londonhackspace/acnode-serialreader/Hardware/Readme.md

ACNode Serial Reader Hardware
=============

Errata - V1.1
----
* The RX and TX lines are backwards on connector J6 - Silkscreen is as intended NOT as implemented!
