londonhackspace/acnode-serialreader/Hardware/ACNodeReader-schematic.pdf

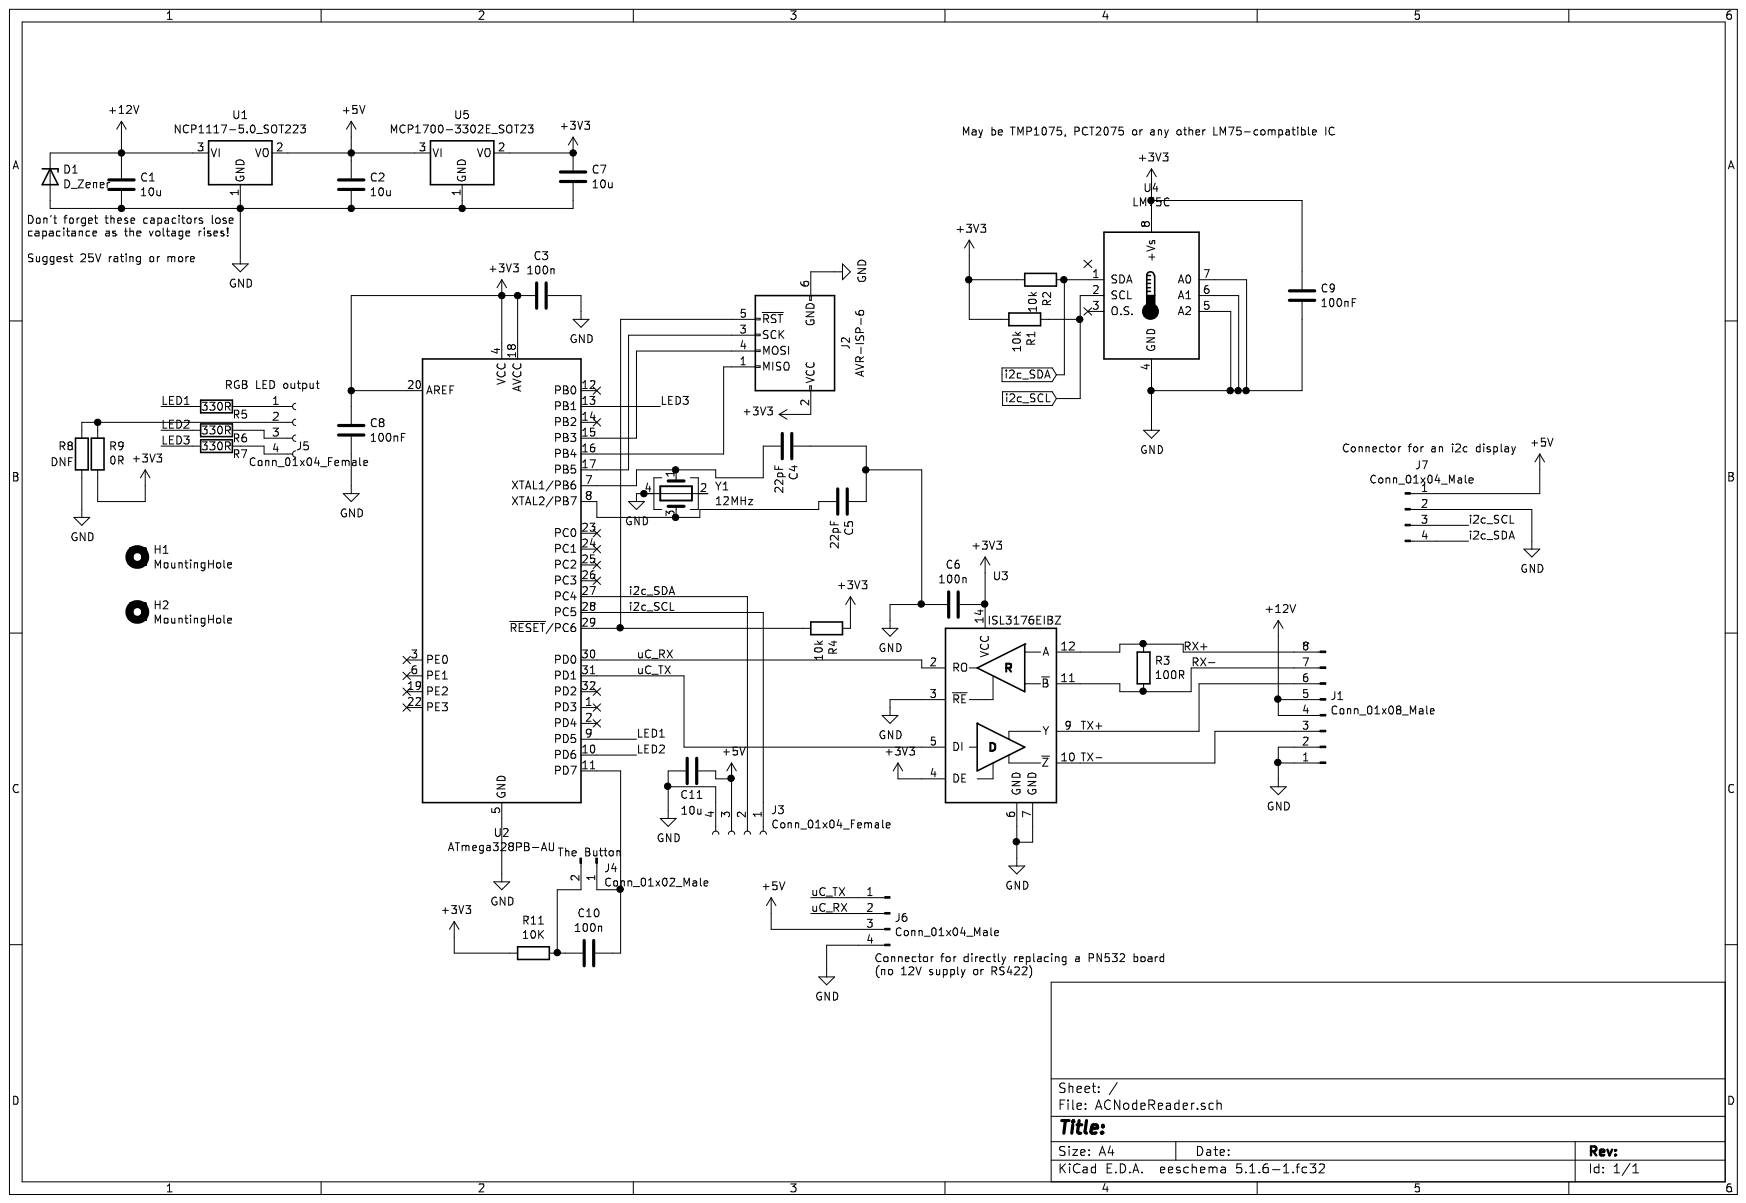
[picture p1: page 1]
