londonhackspace/acnode-serialreader/Hardware/ACNodeReader-board.pdf

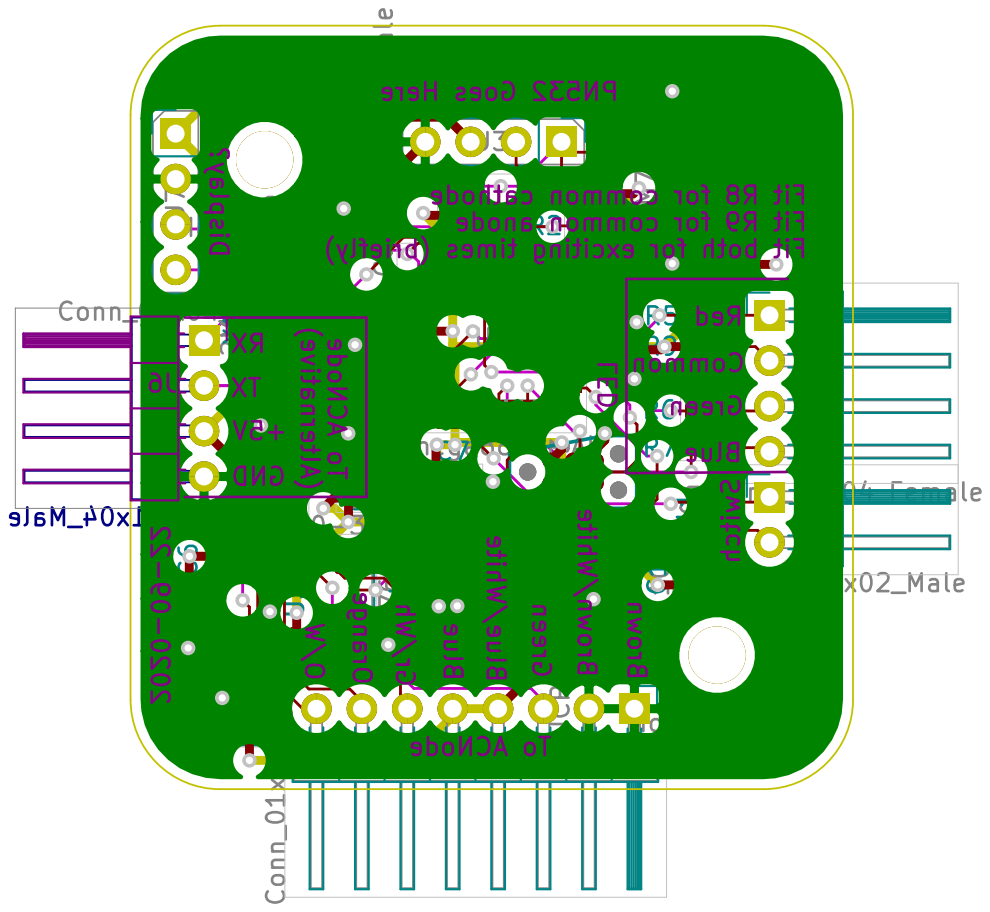
[picture p2: page 1]
