londonhackspace/acnode-serialreader/Hardware/ACNodeReader.kicad_pcb

## KiCad design Hardware/ACNodeReader.kicad_pcb (2020-10-10)

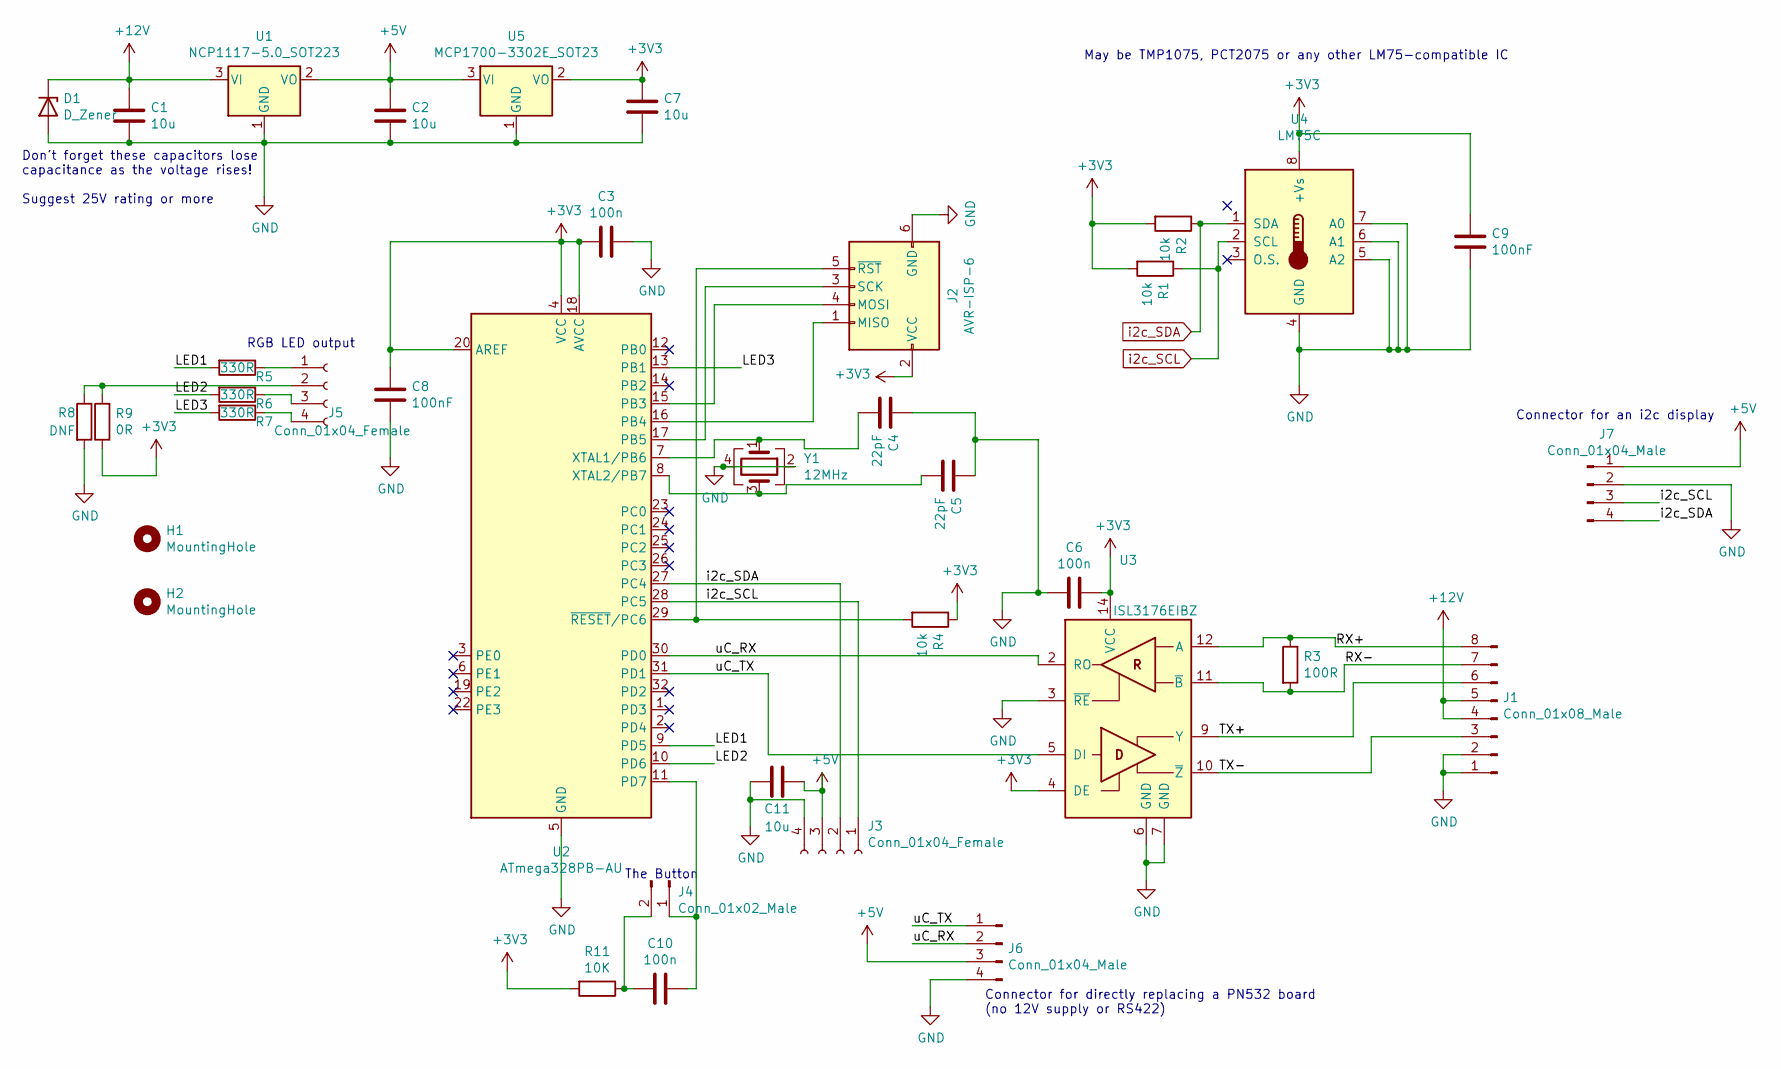
[picture p3: schematic ACNodeReader.sch]

Parts:
C1, C2, C7, C11: 10u; C_0805_2012Metric
C3, C6, C10: 100n; C_0603_1608Metric
C4, C5: 22pF; C_0603_1608Metric
C8, C9: 100nF; C_0603_1608Metric
D1: D_Zener; D_SOD-323F
H1, H2: MountingHole; MountingHole_3.2mm_M3_DIN965
J1: Conn_01x08_Male; PinHeader_1x08_P2.54mm_Horizontal
J2: AVR-ISP-6; TC2030-MCP-NL
J3: Conn_01x04_Female; PinHeader_1x04_P2.54mm_Vertical
J4: Conn_01x02_Male; PinHeader_1x02_P2.54mm_Horizontal
J5: Conn_01x04_Female; PinHeader_1x04_P2.54mm_Horizontal
J6: Conn_01x04_Male; PinHeader_1x04_P2.54mm_Horizontal
J7: Conn_01x04_Male; PinHeader_1x04_P2.54mm_Vertical
R1, R2, R4: 10k; R_0603_1608Metric
R3: 100R; R_0603_1608Metric
R5, R6, R7: 330R; R_0603_1608Metric
R8: DNF; R_0603_1608Metric
R9: 0R; R_0603_1608Metric
R11: 10K; R_0603_1608Metric
U1: NCP1117-5.0_SOT223; SOT-223-3_TabPin2
U2: ATmega328PB-AU; TQFP-32_7x7mm_P0.8mm
U3: ISL3176EIBZ; SOIC-14_3.9x8.7mm_P1.27mm
U4: LM75C; SO-8_3.9x4.9mm_P1.27mm
U5: MCP1700-3302E_SOT23; SOT-23
Y1: 12MHz; Crystal_SMD_7050-4Pin_7.0x5.0mm

Connections:
+3V3: C3.2, C6.1, C7.1, C8.1, C9.1, J2.2 (VCC), R1.2, R2.2, R4.1, R9.1, R11.2, U2.4 (VCC), U2.18 (AVCC), U2.20 (AREF), U3.4 (DE), U3.14 (VCC), U4.8 (+Vs), U5.2 (VO)
+5V: C2.1, C11.1, J3.3, J6.3, J7.1, U1.2 (VO), U5.3 (VI)
+12V: C1.1, D1.1 (K), J1.4, J1.5, U1.3 (VI)
/LED1: R5.2, U2.9 (PD5)
/LED2: R6.2, U2.10 (PD6)
/LED3: R7.2, U2.13 (PB1)
/RX+: J1.8, R3.1, U3.12 (A)
/RX-: J1.7, R3.2, U3.11 (~B)
/TX+: J1.6, U3.9 (Y)
/TX-: J1.3, U3.10 (~Z~)
/uC_RX: J6.2, U2.30 (PD0), U3.2 (RO)
/uC_TX: J6.1, U2.31 (PD1), U3.5 (DI)
GND: C1.2, C2.2, C3.1, C4.1, C5.1, C6.2, C7.2, C8.2, C9.2, C11.2, D1.2 (A), J1.1, J1.2, J2.6 (GND), J3.4, J6.4, J7.2, R8.2, U1.1 (GND), U2.5 (GND), U2.21 (GND), U3.3 (~RE), U3.6 (GND), U3.7 (GND), U4.4 (GND), U4.5 (A2), U4.6 (A1), U4.7 (A0), U5.1 (GND), Y1.2, Y1.4
unnamed: C4.2, U2.7 (XTAL1/PB6), Y1.1
unnamed: C5.2, U2.8 (XTAL2/PB7), Y1.3
unnamed: C10.1, J4.1, U2.11 (PD7)
unnamed: C10.2, J4.2, R11.1
unnamed: J2.1 (MISO), U2.16 (PB4)
unnamed: J2.3 (SCK), U2.17 (PB5)
unnamed: J2.4 (MOSI), U2.15 (PB3)
unnamed: J2.5 (~RST), R4.2, U2.29 (~RESET~/PC6)
unnamed: J5.1, R5.1
unnamed: J5.2, R8.1, R9.2
unnamed: J5.3, R6.1
unnamed: J5.4, R7.1
i2c_SCL: J3.1, J7.3, R1.1, U2.28 (PC5), U4.2 (SCL)
i2c_SDA: J3.2, J7.4, R2.1, U2.27 (PC4), U4.1 (SDA)

Notes on the sheet:
May be TMP1075, PCT2075 or any other LM75-compatible IC
Connector for an i2c display
Connector for directly replacing a PN532 board (no 12V supply or RS422)
The Button
RGB LED output
Don't forget these capacitors lose capacitance as the voltage rises! Suggest 25V rating or more

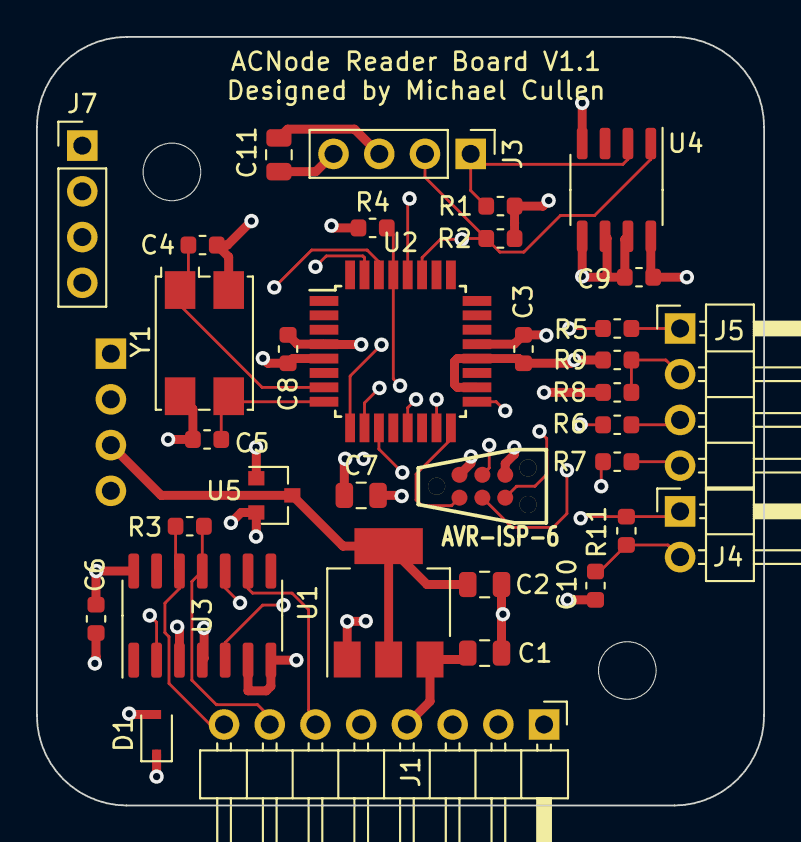
[picture p4: board ACNodeReader.kicad_pcb from above]

Board: 4 copper layers, 40.4 x 42.7 mm, 37 parts (1 on the bottom side), 27 nets.
