londonhackspace/acnode-serialreader/Hardware/ACNodeAdaptor/ACNodeAdaptor.kicad_pcb

## KiCad design Hardware/ACNodeAdaptor/ACNodeAdaptor.kicad_pcb (2020-09-22)

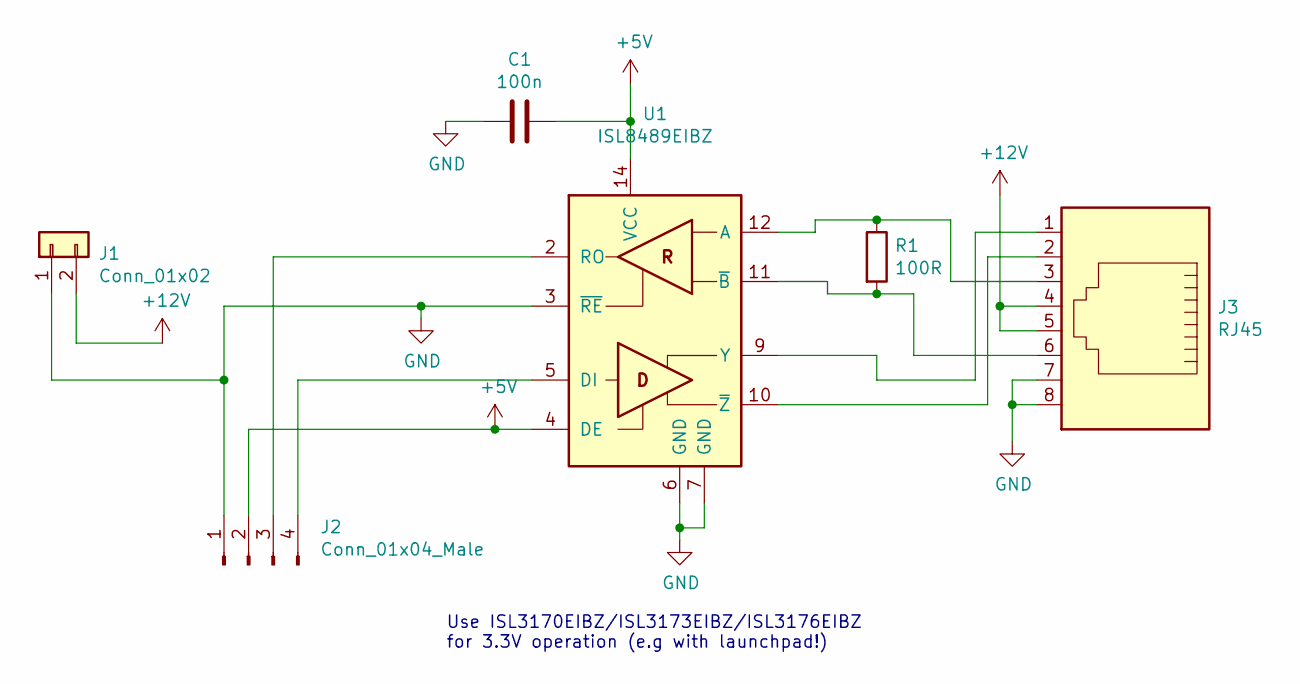
[picture p5: schematic ACNodeAdaptor.sch]

Parts:
C1: 100n; C_0603_1608Metric
J1: Conn_01x02; Connector-5.08mm
J2: Conn_01x04_Male; PinHeader_1x04_P2.54mm_Vertical
J3: RJ45; RJ45_Amphenol_54602-x08_Horizontal
R1: 100R; R_0603_1608Metric
U1: ISL8489EIBZ; SOIC-14_3.9x8.7mm_P1.27mm

Connections:
+5V: C1.1, J2.2, U1.4 (DE), U1.14 (VCC)
+12V: J1.2, J3.4, J3.5
GND: C1.2, J1.1, J2.1, J3.7, J3.8, U1.3 (~RE), U1.6 (GND), U1.7 (GND)
unnamed: J2.3, U1.2 (RO)
unnamed: J2.4, U1.5 (DI)
unnamed: J3.1, U1.9 (Y)
unnamed: J3.2, U1.10 (~Z~)
unnamed: J3.3, R1.1, U1.12 (A)
unnamed: J3.6, R1.2, U1.11 (~B)

Notes on the sheet:
Use ISL3170EIBZ/ISL3173EIBZ/ISL3176EIBZ for 3.3V operation (e.g with launchpad!)

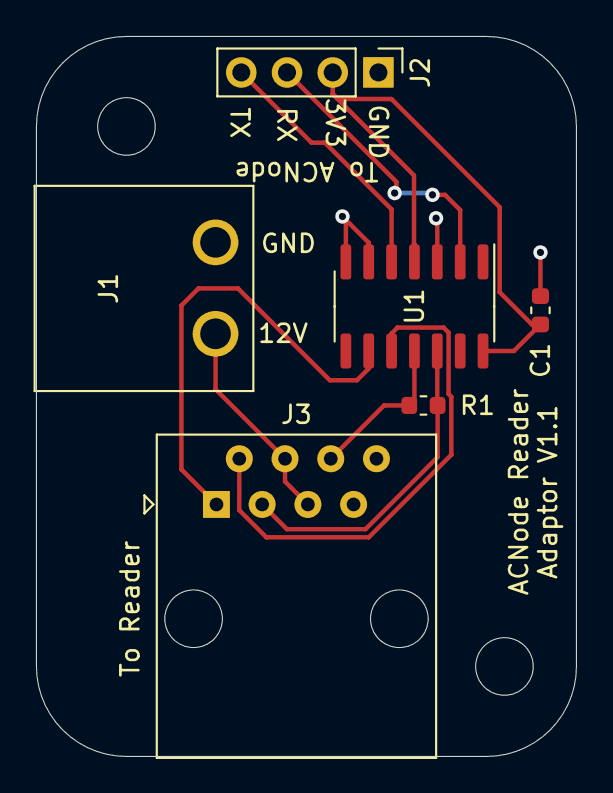
[picture p6: board ACNodeAdaptor.kicad_pcb from above]

Board: 2 copper layers, 30.0 x 40.0 mm, 6 parts (0 on the bottom side), 9 nets.
