londonhackspace/acnode-serialreader/Hardware/USB/USB.kicad_pcb

## KiCad design Hardware/USB/USB.kicad_pcb (2019-09-19)

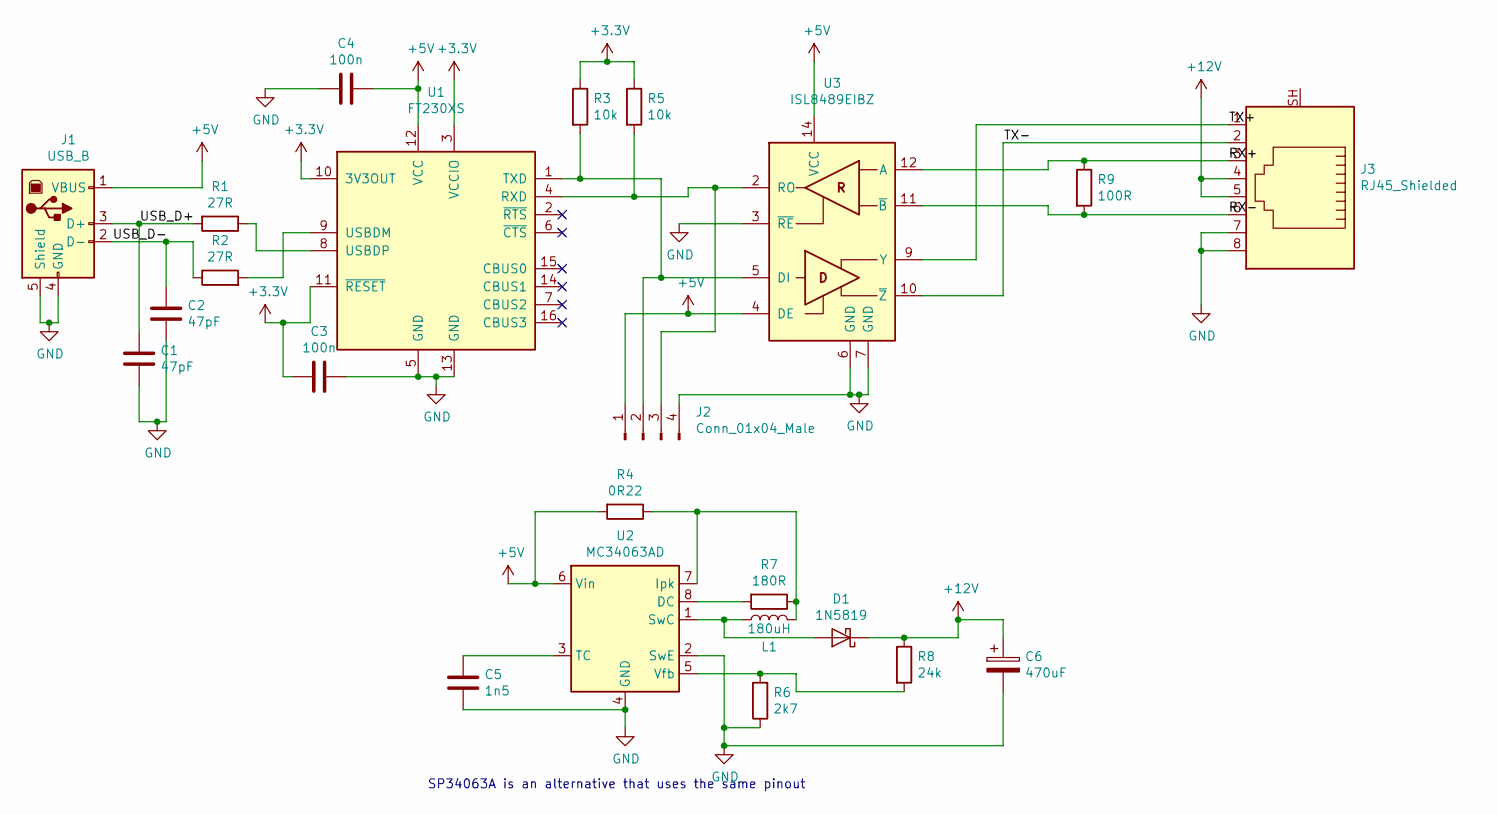
[picture p7: schematic USB.sch]

Parts:
C1, C2: 47pF; C_0603_1608Metric
C3, C4: 100n; C_0603_1608Metric
C5: 1n5; C_0603_1608Metric
C6: 470uF; CP_Elec_8x10
D1: 1N5819; D_DO-41_SOD81_P10.16mm_Horizontal
J1: USB_B; USB_B_OST_USB-B1HSxx_Horizontal
J2: Conn_01x04_Male; PinHeader_1x04_P2.54mm_Vertical
J3: RJ45_Shielded; RJ45_Amphenol_54602-x08_Horizontal
L1: 180uH; L_12x12mm_H8mm
R1, R2: 27R; R_0603_1608Metric
R3, R5: 10k; R_0603_1608Metric
R4: 0R22; R_0603_1608Metric
R6: 2k7; R_0603_1608Metric
R7: 180R; R_0603_1608Metric
R8: 24k; R_0603_1608Metric
R9: 100R; R_0603_1608Metric
U1: FT230XS; SSOP-16_3.9x4.9mm_P0.635mm
U2: MC34063AD; SOIC-8_3.9x4.9mm_P1.27mm
U3: ISL8489EIBZ; SOIC-14_3.9x8.7mm_P1.27mm

Connections:
+3V3: C3.2, R3.1, R5.1, U1.3 (VCCIO), U1.10 (3V3OUT), U1.11 (~RESET)
+5V: C4.1, J1.1 (VBUS), J2.1, R4.2, U1.12 (VCC), U2.6 (Vin), U3.4 (DE), U3.14 (VCC)
+12V: C6.1, D1.1 (K), J3.4, J3.5, R8.1
/RX+: J3.3, R9.1, U3.12 (A)
/RX-: J3.6, R9.2, U3.11 (~B)
/TX+: J3.1, U3.9 (Y)
/TX-: J3.2, U3.10 (~Z~)
/USB_D+: C1.1, J1.3 (D+), R1.2
/USB_D-: C2.1, J1.2 (D-), R2.1
GND: C1.2, C2.2, C3.1, C4.2, C5.2, C6.2, J1.4 (GND), J1.5 (Shield), J2.4, J3.7, J3.8, R6.1, U1.5 (GND), U1.13 (GND), U2.2 (SwE), U2.4 (GND), U3.3 (~RE), U3.6 (GND), U3.7 (GND)
unnamed: C5.1, U2.3 (TC)
unnamed: D1.2 (A), L1.1, U2.1 (SwC)
unnamed: J2.2, R3.2, U1.1 (TXD), U3.5 (DI)
unnamed: J2.3, R5.2, U1.4 (RXD), U3.2 (RO)
unnamed: L1.2, R4.1, R7.1, U2.7 (Ipk)
unnamed: R1.1, U1.8 (USBDP)
unnamed: R2.2, U1.9 (USBDM)
unnamed: R6.2, R8.2, U2.5 (Vfb)
unnamed: R7.2, U2.8 (DC)

Notes on the sheet:
SP34063A is an alternative that uses the same pinout

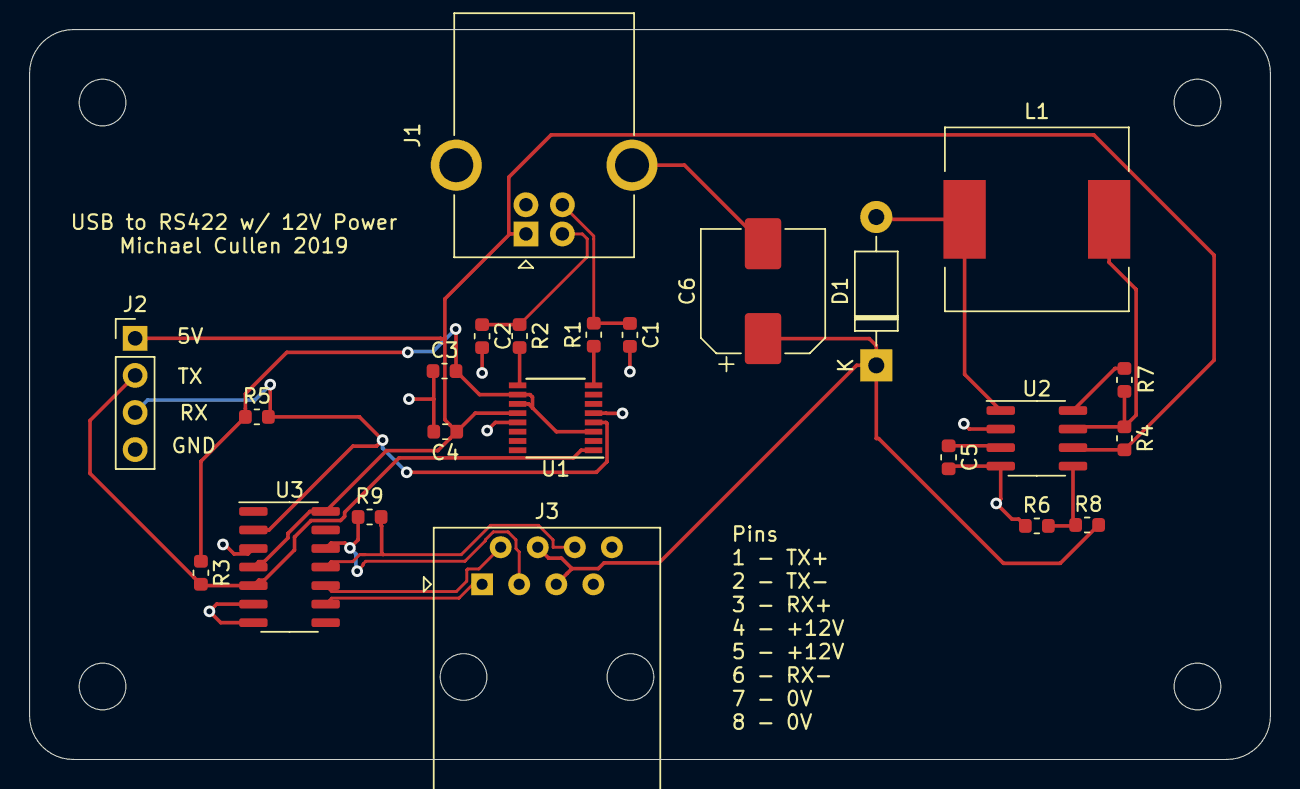
[picture p8: board USB.kicad_pcb from above]

Board: 2 copper layers, 85.0 x 50.0 mm, 23 parts (0 on the bottom side), 19 nets.
