londonhackspace/acnode-serialreader/Hardware/ACNodeReader_Debug.kicad_pcb

## KiCad design Hardware/ACNodeReader_Debug.kicad_pcb (2019-08-09)

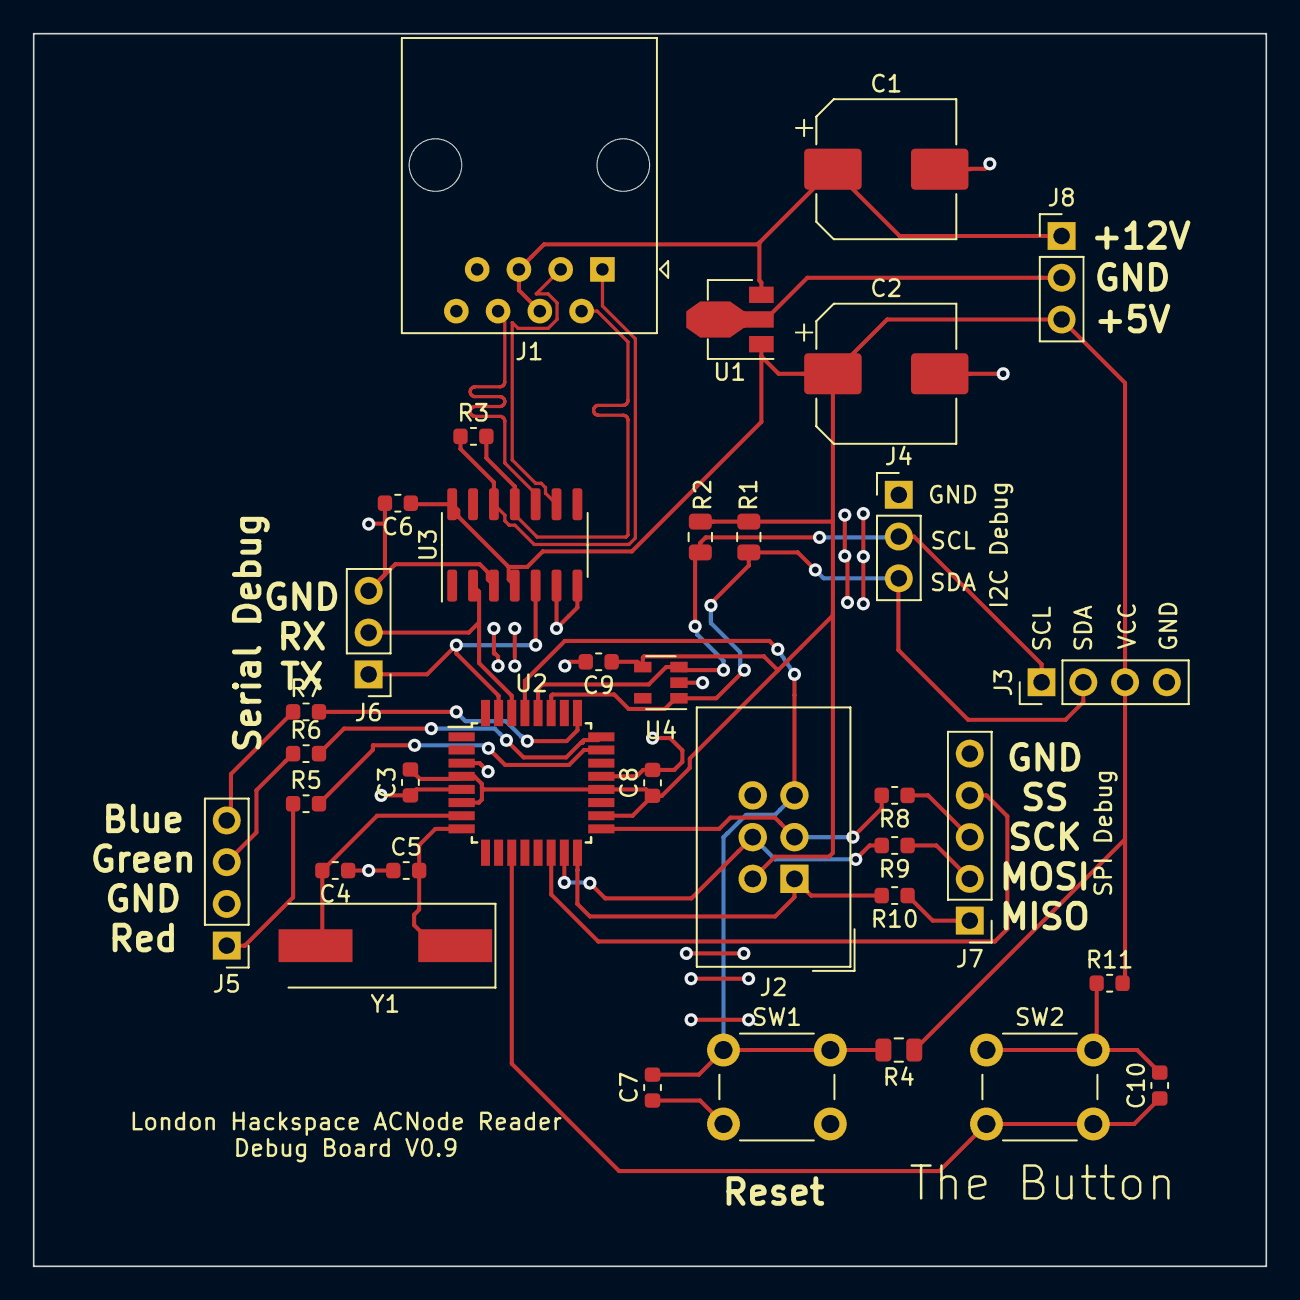
[picture p9: board ACNodeReader_Debug.kicad_pcb from above]

Board: 2 copper layers, 75.0 x 75.0 mm, 36 parts (0 on the bottom side), 29 nets.

Parts:
C1, C2: 470u; CP_Elec_8x10
C3, C6, C10: 100n; C_0603_1608Metric
C4, C5: 22pF; C_0603_1608Metric
C7: 4.7nF; C_0603_1608Metric
C8, C9: 100nF; C_0603_1608Metric
J1: 8P8C; RJ45_Amphenol_54602-x08_Horizontal
J2: AVR-ISP-6; IDC-Header_2x03_P2.54mm_Vertical
J3, J5: Conn_01x04_Female; PinHeader_1x04_P2.54mm_Vertical
J4, J6, J8: Conn_01x03_Male; PinHeader_1x03_P2.54mm_Vertical
J7: Conn_01x05_Male; PinHeader_1x05_P2.54mm_Vertical
R1, R2, R4: 10k; R_0805_2012Metric
R3: 100R; R_0603_1608Metric
R5, R6, R7: 1K; R_0603_1608Metric
R8, R9, R10: 220R; R_0603_1608Metric
R11: R; R_0603_1608Metric
SW1, SW2: SW_Push; SW_PUSH_6mm
U1: L78L05_SOT89; SOT-89-3
U2: ATmega88-20AU; TQFP-32_7x7mm_P0.8mm
U3: ISL8489EIBZ; SOIC-14_3.9x8.7mm_P1.27mm
U4: SI7060-B-00-IV; SOT-23-5
Y1: 16MHz; Crystal_SMD_HC49-SD

Connections:
+5V: C2.1, C3.2, C6.1, C8.1, C9.1, J2.2, J3.3, J8.3, R1.2, R2.2, R4.1, R11.2, U1.1, U2.4, U2.6, U2.18, U2.20, U3.4, U3.14, U4.4
+12V: C1.1, J1.4, J1.5, J8.1, U1.3
/RX+: J1.1, R3.1, U3.12
/RX-: J1.2, R3.2, U3.11
/TX+: J1.3, U3.9
/TX-: J1.6, U3.10
GND: C1.2, C2.2, C3.1, C4.1, C5.1, C6.2, C7.1, C8.2, C9.2, J1.7, J1.8, J2.6, J3.4, J4.1, J5.2, J6.3, J7.5, J8.2, SW1.2, U1.2, U2.3, U2.5, U2.21, U3.3, U3.6, U3.7, U4.2
unnamed: C4.2, U2.7, Y1.2
unnamed: C5.2, U2.8, Y1.1
unnamed: C7.2, J2.5, R4.2, SW1.1, U2.29
unnamed: C10.1, SW2.2, U2.11
unnamed: C10.2, R11.1, SW2.1
unnamed: J2.1, R10.2, U2.16
unnamed: J2.3, R8.2, U2.17
unnamed: J2.4, R9.2, U2.15
unnamed: J5.1, R5.1
unnamed: J5.3, R6.1
unnamed: J5.4, R7.1
unnamed: J7.1, R10.1
unnamed: J7.2, R9.1
unnamed: J7.3, R8.1
unnamed: J7.4, U2.14
unnamed: R5.2, U2.23
unnamed: R6.2, U2.24
unnamed: R7.2, U2.25
i2c_SCL: J3.1, J4.2, R2.1, U2.28, U4.3
i2c_SDA: J3.2, J4.3, R1.1, U2.27, U4.1
uC_RX: J6.2, U2.30, U3.2
uC_TX: J6.1, U2.31, U3.5
