londonhackspace/acnode-serialreader/(commit log)

2019-08-08 Added debug hardware
    The aim of this board is to prove the ideas. It has extra
    pins broken out for debugging and testing.
    [ACNodeReader.sch, ACNodeReader_Debug.kicad_pcb]
2019-08-09 Added gerbers
    [ACNodeReader_Debug-B_Cu.gbr, ACNodeReader_Debug-B_Mask.gbr, ACNodeReader_Debug-B_Paste.gbr, ACNodeReader_Debug-B_SilkS.gbr, ACNodeReader_Debug-Edge_Cuts.gbr, ACNodeReader_Debug-F_Cu.gbr, ACNodeReader_Debug-F_Mask.gbr, ACNodeReader_Debug-F_Paste.gbr]
2019-08-18 Update a component value
    [ACNodeReader.sch]
2019-08-18 Firmware: Add support for new debug board
2019-08-18 Firmware: lower i2c bitrate
    Initially the code was using 400KHz I2C however that's rather high.
    It is a valid bitrate of I2C for the devices involved, but being so high,
    it's likely to be less reliable - so lower to 100KHz at least until we
    get things working properly
2019-08-18 Firmware: Added missing header file
    [target.h]
2019-08-18 Firmware: Add some error checking to headers
    [serial.h, target.h]
2019-08-18 Added (simple) temperature sensor support
    This commit adds support for the SI7060 I2C temperature sensor on supported boards.
2019-09-19 USB to Reader Board Board
    [USB-B_Cu.gbr, USB-B_Mask.gbr, USB-B_Paste.gbr, USB-B_SilkS.gbr, USB-Edge_Cuts.gbr, USB-F_Cu.gbr, USB-F_Mask.gbr, USB-F_Paste.gbr]
2020-05-25 Random locl changes
    [ACNodeReader.csv, ACNodeReader.kicad_pcb, ACNodeReader.sch]
2020-06-09 Toying with the circuit a bit
    Removed the capacitor across reset since it breaks DebugWire which
    is worth having usable because it helps when all hell breaks loose :-)
    Added zero ohm links for switching LED from common anode to common cathode
    Switched capacitors to (much smaller) MLCC variants in preparation for attempting
    to cram everything into a smaller board
    [ACNodeReader.kicad_pcb, ACNodeReader.sch]
2020-08-28 New, smaller, better PCB design
    [ACNodeReader-B_Cu.gbr, ACNodeReader-B_Mask.gbr, ACNodeReader-B_Paste.gbr, ACNodeReader-B_SilkS.gbr, ACNodeReader-Edge_Cuts.gbr, ACNodeReader-F_Cu.gbr, ACNodeReader-F_Mask.gbr, ACNodeReader-F_Paste.gbr]
2020-08-28 Slight schematic changes - mostly text descriptions
    [ACNodeReader.sch]
2020-08-29 Added note about reversed pinout
    [ACNodeReader.kicad_pcb]
2020-08-29 Added adaptor board
    [ACNodeAdaptor-B_Cu.gbr, ACNodeAdaptor-B_Mask.gbr, ACNodeAdaptor-B_Paste.gbr, ACNodeAdaptor-B_SilkS.gbr, ACNodeAdaptor-Edge_Cuts.gbr, ACNodeAdaptor-F_Cu.gbr, ACNodeAdaptor-F_Mask.gbr, ACNodeAdaptor-F_Paste.gbr]
2020-08-30 Note about 3.3V operation (e.g with a launchpad)
    [ACNodeAdaptor.sch]
2020-09-19 Added some notes to schematic and updated firmware with new board support
    getting there!
    [ACNodeReader.kicad_pcb, ACNodeReader.sch]
2020-09-20 Lights: Add support for PWM LEDs on Rev1 board
    We now have dimmable LEDs on the Rev1 board, so no more on/off control!
2020-09-20 Add Rev1 board (Atmega88PB based)
2020-09-20 Reliability fixes
    Still needs some work, but it's looking better than it was
    [commsprotocol.c, i2c.c, i2c.h, pn532.c, pn532.h, testhost.py]
2020-09-20 Add LM75 support
    Basic support for getting temperatures from LM75 and similar sensors
2020-09-22 Hardware V1.1 - 3.3V with chunkier 5V regulator
    The 1.0 5V regulator wasn't chunky enough, so this board has a larger
    one to support the current draw of the PN532 module. Additionally, a
    capacitor has been added near to the PN532 module connector to assist in
    smoothing the supply to it.
    Most of the board now runs at 3.3V, derived from the 5V rail. This is to
    support direct connection to an ACNode, which only support 3.3V IO. This
    required slowing the AVR down to 12MHz. An alternative option would have
    been to use a level shifter on the TX line.
    [ACNodeReader-B_Cu.gbr, ACNodeReader-B_Mask.gbr, ACNodeReader-B_Paste.gbr, ACNodeReader-B_SilkS.gbr, ACNodeReader-Edge_Cuts.gbr, ACNodeReader-F_Cu.gbr, ACNodeReader-F_Mask.gbr, ACNodeReader-F_Paste.gbr]
2020-09-22 ACNodeAdaptor: Minor change to silkscreen
    The ACNode adaptor is actually assembled with a 3.3V RS422 driver, to
    support connection to the ACNode. This board modifies the silkscreen to
    reflect this.
    [ACNodeAdaptor-B_Cu.gbr, ACNodeAdaptor-B_Mask.gbr, ACNodeAdaptor-B_Paste.gbr, ACNodeAdaptor-B_SilkS.gbr, ACNodeAdaptor-Edge_Cuts.gbr, ACNodeAdaptor-F_Cu.gbr, ACNodeAdaptor-F_Mask.gbr, ACNodeAdaptor-F_Paste.gbr]
2020-09-22 Remove old Arduino target
    It isn't much use now, probably doesn't work, and isn't worth maintaining
2020-09-23 Comms and Serial Bug Fixes
    Better handling of junk in the buffer and removed a probable buffer
    overflow
    [commsprotocol.c, serial.c]
2020-10-10 Makefile Tweaks
    Make REV1 default instead of non-existent Arduino target and a few other
    minor tweaks
2020-10-10 Add temperature command
    Adds the ability to query the temperature from the reader
2020-10-10 Add Rev1.1 board support to firmware
    This board runs at 12MHz to be in spec for 3.3V operation of the
    microcontroller
2020-10-10 Make Rev1.1 default in firmware build
    This is the board most likely to be used now so it makes sense for it to
    be the default target
2020-10-10 Make Bootloader fit in 2Kb
    The bootloader was getting too big, so:
    1) make a bootloader mode to remove code not used
    2) remove flow control since it wasn't really much use anyway since we
    wait for responses before sending anything with this protocol
    3) Switch to -Os to make things smaller
    [bootloader.c, commsprotocol.c, serial.c]
2020-10-10 Updated hardware with how I actually assembled it
    I'm leaning towards the ATmega328PB, and also switched to 330R resistors on the LEDs
    [ACNodeReader.kicad_pcb, ACNodeReader.sch]
2020-11-24 More bootloader stuff
    This may have broken debug logging builds, more testing needed
    [bootloader.c, commsprotocol.c, commsprotocol.h, main.c, testhost.py]
2020-12-18 Update schematic PDF
2021-03-22 Fix bug in comms protocol
    [commsprotocol.c]
2021-03-25 MOAR STUFF
    Added some messages, the fonts that were missing from the previous commits,
    and a few other bits
    [commsprotocol.c, commsprotocol.h, main.c, pn532.c]
2021-03-27 Some comms fixes from fuzzing
    I ran AFL over the parser and found a few crashes and hangs. This fixes some of them.
    One nasty one will need a bit more work, so that will have to wait for the next commit
    [commsprotocol.c]
2021-03-29 Add fuzz harness
    This allows stress testing the protocol parser using AFL. It does not
    attempt to parse any message payloads, however it does very effectively
    find problems in the framing and checksum stage.
    [commsfuzzharness.c, mkfuzzers.py]
2021-03-29 Some fixes to the comms protocol.
    It's better, but I think some parts of this need a rethink. It's still getting
    stuck a bit too often, and the way the retry parsing works feels a bit rough
    [commsprotocol.c, commsprotocol.h]
